rammp-org/pace-brake-r/README.md

# pace-brake-r
brake resistor circuit for protecting DC batteries on high power motor controllers
