rammp-org/pace-brake-r/pace-brake-r-core.kicad_pcb

## KiCad design pace-brake-r-core.kicad_pcb (2026-07-31)

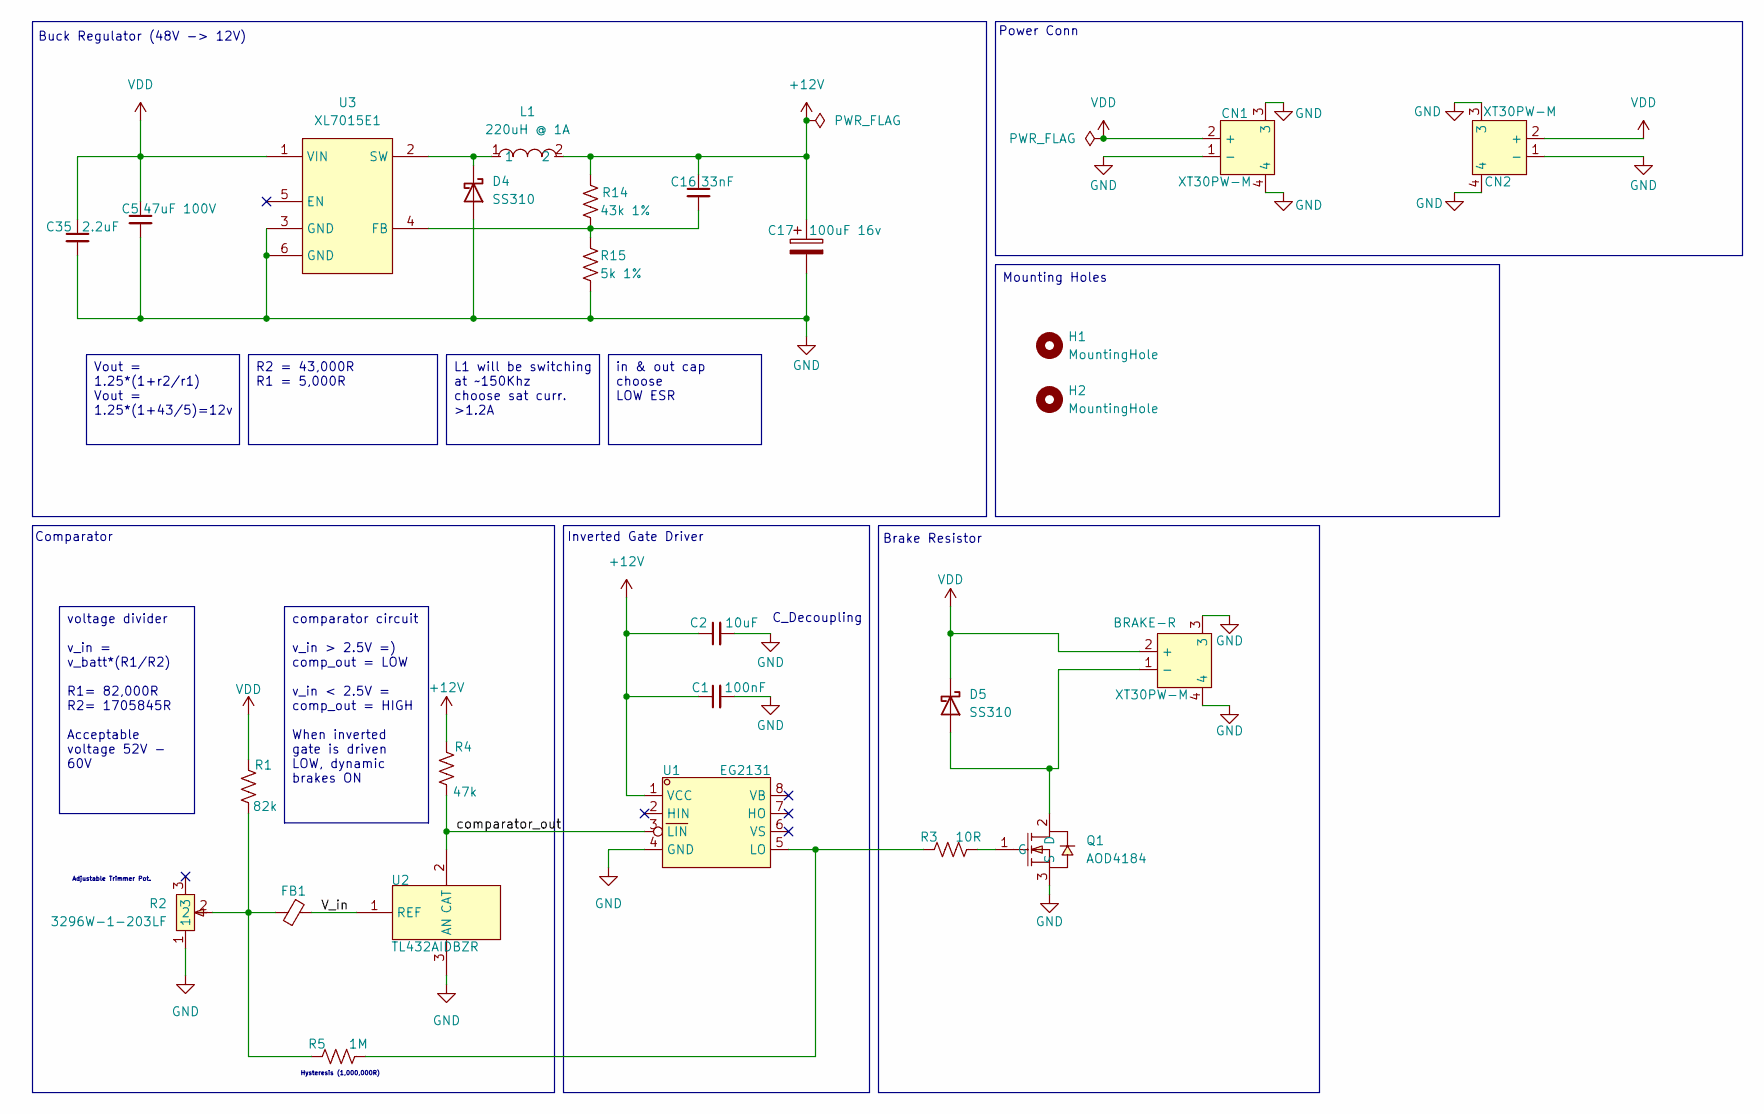
[picture p1: schematic pace-brake-r-core.kicad_sch]

Parts:
BRAKE-R: XT30PW-M; CONN-TH_XT30PW-M; MPN XT30PW-M30.G.Y; LCSC Part C431092
C1: 100nF; C_0402_1005Metric
C2: 10uF; C_0402_1005Metric
C5: 47uF 100V; CP_Elec_10x10
C16: 33nF; C_0402_1005Metric
C17: 100uF 16v; C_Elec_6.3x7.7; MPN EEEFPV101XAP; LCSC part C178585
C35: 2.2uF; C_1210_3225Metric
CN1, CN2: XT30PW-M; CONN-TH_XT30PW-M; MPN XT30PW-M30.G.Y; LCSC Part C431092
D4, D5: SS310; D_SMA
FB1: FerriteBead_Small; L0603
H1, H2: MountingHole; MountingHole_3.2mm_M3
L1: 220uH @ 1A; IND-TH_BD9.0-P5.00-D0.7; MPN RLB9012-221KL; LCSC Part C1330811
Q1: AOD4184; TO-252-2_L6.6-W6.1-P4.58-LS9.9-BR; MPN AOD4184-VB; LCSC Part C879026
R1: 82k; R_0402_1005Metric
R2: 3296W-1-203LF; RES-ADJ-TH_3P-L10.0-W10.0-P2.50-BL-BS; MPN 3296W-1-203LF; LCSC Part C34845
R3: 10R; R_0402_1005Metric
R4: 47k; R_0402_1005Metric
R5: 1M; R_0402_1005Metric
R14: 43k 1%; R_0402_1005Metric
R15: 5k 1%; R_0402_1005Metric
U1: EG2131; SOIC-8_L5.0-W4.0-P1.27-LS6.0-BL; MPN EG2131; LCSC Part C193777
U2: TL432AIDBZR; SOT-23-3_L2.9-W1.3-P1.90-LS2.4-BR; MPN TL432AIDBZR; LCSC Part C82720
U3: XL7015E1; TO-252-5_L6.6-W5.8-P1.27-TL; MPN XL7015E1; LCSC Part C73013

Connections:
+12V: C1.1, C2.1, C16.1, C17.1, L1.2, R4.1, R14.1, U1.1 (VCC)
GND: BRAKE-R.3, BRAKE-R.4, C1.2, C2.2, C5.2, C17.2, C35.2, CN1.1 (-), CN1.3, CN1.4, CN2.1 (-), CN2.3, CN2.4, D4.2 (A), Q1.3 (S), R2.1, R15.2, U1.4 (GND), U2.3 (AN), U3.3 (GND), U3.6 (GND); also elsewhere on the board
unnamed 2: BRAKE-R.1 (-), D5.2 (A), Q1.2 (D); also elsewhere on the board
unnamed: D4.1 (K), L1.1, U3.2 (SW)
unnamed: FB1.2, R1.2, R2.2, R5.1
unnamed: Q1.1 (G), R3.2
unnamed: R4.2, U1.3 (LIN), U2.2 (CAT)
unnamed: R3.1, R5.2, U1.5 (LO)
unnamed: FB1.1, U2.1 (REF)
unnamed: C16.2, R14.2, R15.1, U3.4 (FB)
VDD: BRAKE-R.2 (+), C5.1, C35.1, CN1.2 (+), CN2.2 (+), D5.1 (K), R1.1, U3.1 (VIN); also elsewhere on the board

Notes on the sheet:
Buck Regulator (48V -> 12V)
Power Conn
Inverted Gate Driver
C_Decoupling
Mounting Holes
Brake Resistor
Hysteresis (1,000,000R)
Comparator
Adjustable Trimmer Pot.
voltage divider v_in = v_batt*(R1/R2) R1= 82,000R R2= 1705845R Acceptable voltage 52V - 60V
in & out cap choose LOW ESR
Vout = 1.25*(1+r2/r1) Vout = 1.25*(1+43/5)=12v
comparator circuit v_in > 2.5V =) comp_out = LOW v_in < 2.5V = comp_out = HIGH When inverted gate is driven LOW, dynamic brakes ON
R2 = 43,000R R1 = 5,000R
L1 will be switching at ~150Khz choose sat curr. >1.2A

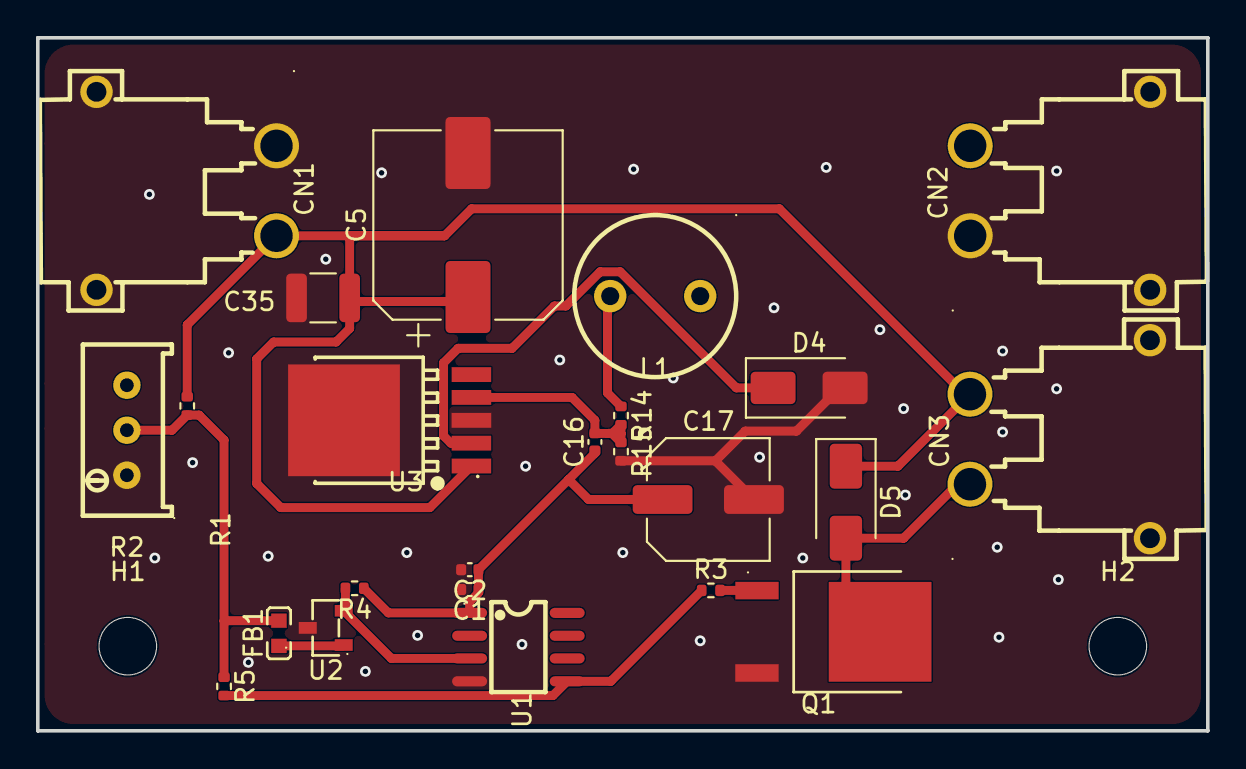
[picture p2: board pace-brake-r-core.kicad_pcb from above]

Board: 4 copper layers, 65.0 x 38.5 mm, 26 parts (0 on the bottom side), 11 nets.

Other parts of the board:
CN3: XT30PW-M; CONN-TH_XT30PW-M

Their connections:
GND: CN3.3, CN3.4; also elsewhere on the board
unnamed 2: CN3.1 (-); also elsewhere on the board
VDD: CN3.2 (+); also elsewhere on the board
