rammp-org/pace-brake-r/(commit log)

2026-07-24 Schematic theory and layout
    [pace-brake-r-core.kicad_pcb, pace-brake-r-core.kicad_sch]
2026-07-24 updated notes in schematic
    [pace-brake-r-core.kicad_sch]
2026-07-29 Last version with LED indicator
    [pace-brake-r-core.kicad_pcb, pace-brake-r-core.kicad_sch]
2026-07-29 Removed LED indicator, begin PCB layout
    [pace-brake-r-core.kicad_pcb, pace-brake-r-core.kicad_sch]
2026-07-30 Continue PCB layout progress
    [pace-brake-r-core.kicad_pcb, pace-brake-r-core.kicad_sch]
2026-07-31 schematic revision changes
    [pace-brake-r-core.kicad_pcb, pace-brake-r-core.kicad_sch]
